HillBalliet/real-time-lightshow/Parts.txt

Wall Adapter:
    https://www.digikey.com/product-detail/en/cui-inc/SWI25-5-N-P5/102-4196-ND/7070092
    Price: $13.54
    Output Voltage: 5V
    Output Power: 20W
    Mate: https://www.digikey.com/product-detail/en/mpd-memory-protection-devices/EJ503A/EJ503A-ND/5431753

    https://www.digikey.com/product-detail/en/triad-magnetics/WSU050-1500/237-1417-ND/3094943
    Price: $7.75
    Output Voltage: 5V
    Output Power: 7.5W

MOSFETs:
    https://www.digikey.com/product-detail/en/diodes-incorporated/DMP2215L-7/DMP2215LDICT-ND/1774242
    Manufacturer: Diodes Incorporated
    Manufacturer PN: DMP2215L-7
    Type: P channel
    Price: $0.32 at 10
    Vds: 20V
    Rds On: 100mOhm
    Drive voltage: 2.5, 4.5V
    Continuous Current: 2.7A

    https://www.digikey.com/product-detail/en/rohm-semiconductor/RU1J002YNTCL/RU1J002YNTCLCT-ND/5042587
    Manufacturer: Rohm Semiconductor
    Manufacturer PN: RU1J002YNTCL
    Type: N channel
    Price: $0.23
    Vds: 50V
    Rds On: 2.2Ohm
    Drive voltage: 0.9, 4.5V
    Continuous Current: 200mA

Current limiting resistors (for n-channel mosfet)
    Manufacturer: TE Connectivity Passive Product
    Manufacturer PN: CRG0402J1K0
    Resistance: 1 kOhm
    Power Rating: 1/16 W
    Footprint: 0402

MuddPi Connector
    URL: https://www.digikey.com/product-detail/en/sullins-connector-solutions/PPPC201LFBN-RC/S7053-ND/810192

RasPi Connector
    URL: https://www.digikey.com/product-detail/en/sullins-connector-solutions/SFH11-PBPC-D20-ST-BK/S9200-ND/1990093

LED Connector
    Stock room 16 pin header

Board Vendor
    URL: http://docs.oshpark.com/services/
    Pricing: $5 per in^2 for 3 boards
    Shipping time: 12 days
    Trace Space: 6 mil
    Drill Size: 10 mil
    Annular Ring: 5 mil
