HillBalliet/real-time-lightshow/power_board.kicad_pcb

## KiCad design power_board.kicad_pcb (2017-10-31)

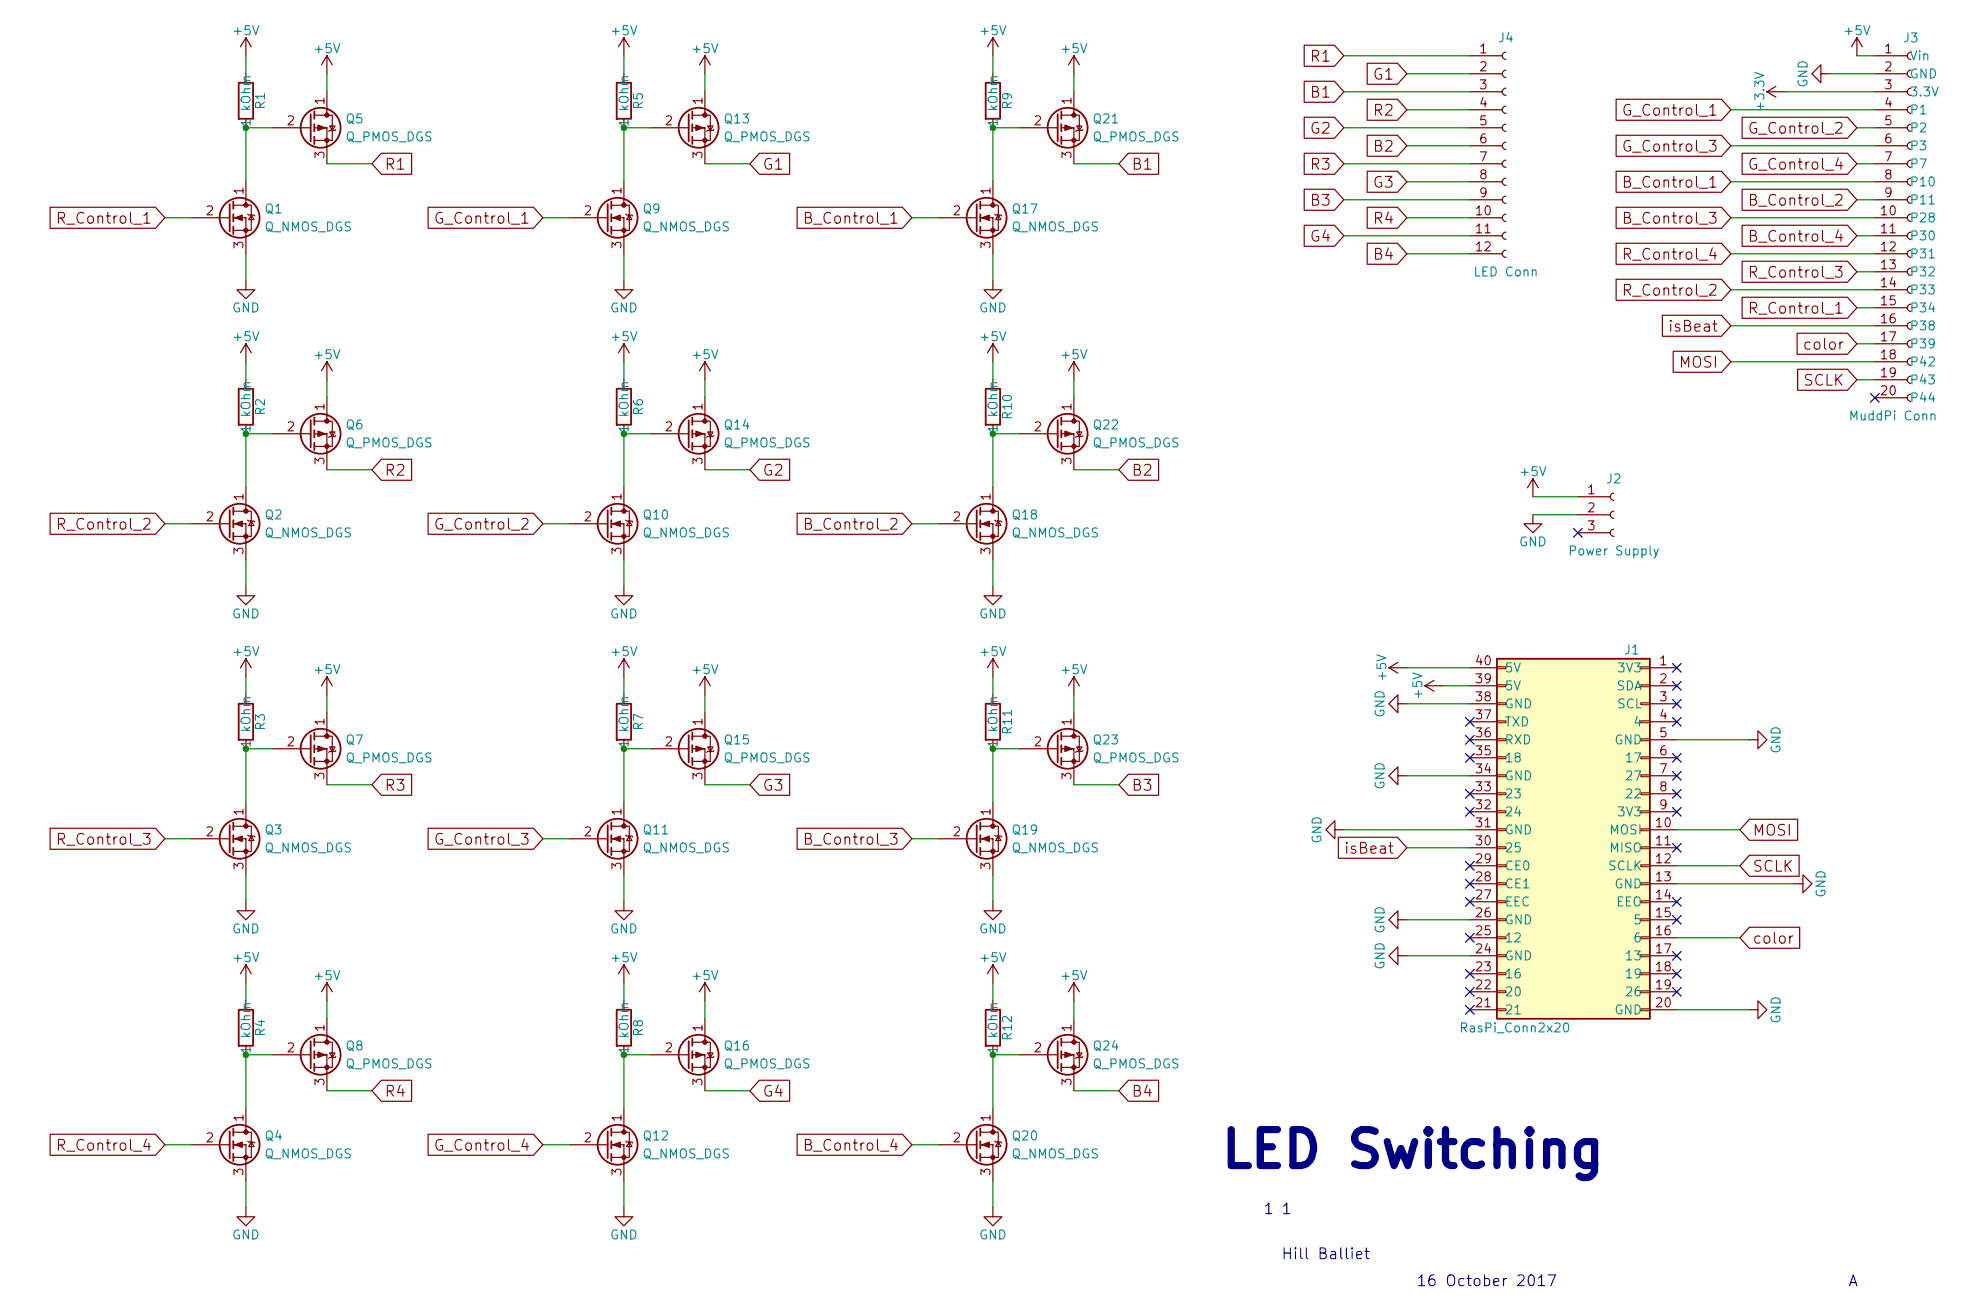
[picture p1: schematic power_board.sch]

Parts:
J1: RasPi_Conn2x20; Molex_2x20
J2: Power Supply; BARREL_JACK
J3: MuddPi Conn; Molex_1x20; Manufacturer PN PPPC201LFBN-RC
J4: LED Conn; Molex_KK-6410-12_12x2.54mm_Straight
Q1, Q2, Q3, Q4, Q9, Q10, Q11, Q12, Q17, Q18, Q19, Q20: Q_NMOS_DGS; SOT-323FL; Drive Voltage 0.9, 4.5V; Manufacturer PN RU1J002YNTCL
Q5, Q6, Q7, Q8, Q13, Q14, Q15, Q16, Q21, Q22, Q23, Q24: Q_PMOS_DGS; SOT-23; Drive Voltage 2.5, 4.5V; Manufacturer PN DMP2215L-7
R1, R2, R3, R4, R5, R6, R7, R8, R9, R10, R11, R12: 1 kOhm; R_0402; Manufacturer PN CRG0402J1K0

Connections:
+3V3: J3.3 (3.3V)
+5V: J1.39 (5V), J1.40 (5V), J2.1, J3.1 (Vin), Q5.1 (D), Q6.1 (D), Q7.1 (D), Q8.1 (D), Q13.1 (D), Q14.1 (D), Q15.1 (D), Q16.1 (D), Q21.1 (D), Q22.1 (D), Q23.1 (D), Q24.1 (D), R1.1, R2.1, R3.1, R4.1, R5.1, R6.1, R7.1, R8.1, R9.1, R10.1, R11.1, R12.1
B1: J4.3, Q21.3 (S)
B2: J4.6, Q22.3 (S)
B3: J4.9, Q23.3 (S)
B4: J4.12, Q24.3 (S)
B_Control_1: J3.8 (P10), Q17.2 (G)
B_Control_2: J3.9 (P11), Q18.2 (G)
B_Control_3: J3.10 (P28), Q19.2 (G)
B_Control_4: J3.11 (P30), Q20.2 (G)
G1: J4.2, Q13.3 (S)
G2: J4.5, Q14.3 (S)
G3: J4.8, Q15.3 (S)
G4: J4.11, Q16.3 (S)
GND: J1.5 (GND), J1.13 (GND), J1.20 (GND), J1.24 (GND), J1.26 (GND), J1.31 (GND), J1.34 (GND), J1.38 (GND), J2.2, J3.2 (GND), Q1.3 (S), Q2.3 (S), Q3.3 (S), Q4.3 (S), Q9.3 (S), Q10.3 (S), Q11.3 (S), Q12.3 (S), Q17.3 (S), Q18.3 (S), Q19.3 (S), Q20.3 (S)
G_Control_1: J3.4 (P1), Q9.2 (G)
G_Control_2: J3.5 (P2), Q10.2 (G)
G_Control_3: J3.6 (P3), Q11.2 (G)
G_Control_4: J3.7, Q12.2 (G)
MOSI: J1.10 (MOSI), J3.18 (P42)
unnamed: Q1.1 (D), Q5.2 (G), R1.2
unnamed: Q2.1 (D), Q6.2 (G), R2.2
unnamed: Q3.1 (D), Q7.2 (G), R3.2
unnamed: Q4.1 (D), Q8.2 (G), R4.2
unnamed: Q10.1 (D), Q14.2 (G), R6.2
unnamed: Q11.1 (D), Q15.2 (G), R7.2
unnamed: Q12.1 (D), Q16.2 (G), R8.2
unnamed: Q9.1 (D), Q13.2 (G), R5.2
unnamed: Q17.1 (D), Q21.2 (G), R9.2
unnamed: Q18.1 (D), Q22.2 (G), R10.2
unnamed: Q19.1 (D), Q23.2 (G), R11.2
unnamed: Q20.1 (D), Q24.2 (G), R12.2
R1: J4.1, Q5.3 (S)
R2: J4.4, Q6.3 (S)
R3: J4.7, Q7.3 (S)
R4: J4.10, Q8.3 (S)
R_Control_1: J3.15 (P34), Q1.2 (G)
R_Control_2: J3.14 (P33), Q2.2 (G)
R_Control_3: J3.13 (P32), Q3.2 (G)
R_Control_4: J3.12 (P31), Q4.2 (G)
SCLK: J1.12 (SCLK), J3.19 (P43)
color: J1.16 (6), J3.17 (P39)
isBeat: J1.30 (25), J3.16 (P38)

Notes on the sheet:
LED Switching
16 October 2017
Hill Balliet

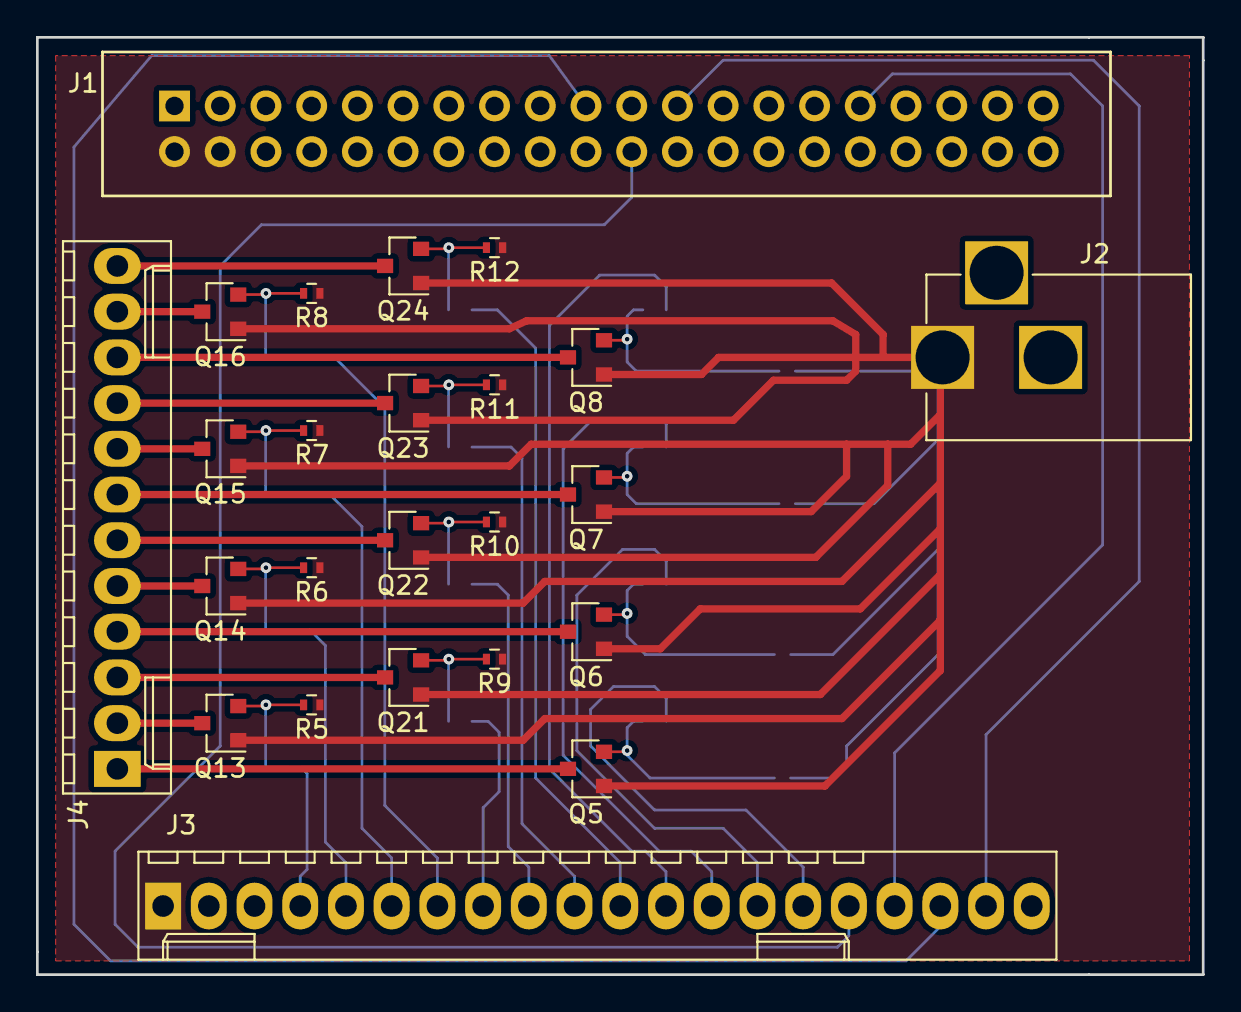
[picture p2: board power_board.kicad_pcb from above]

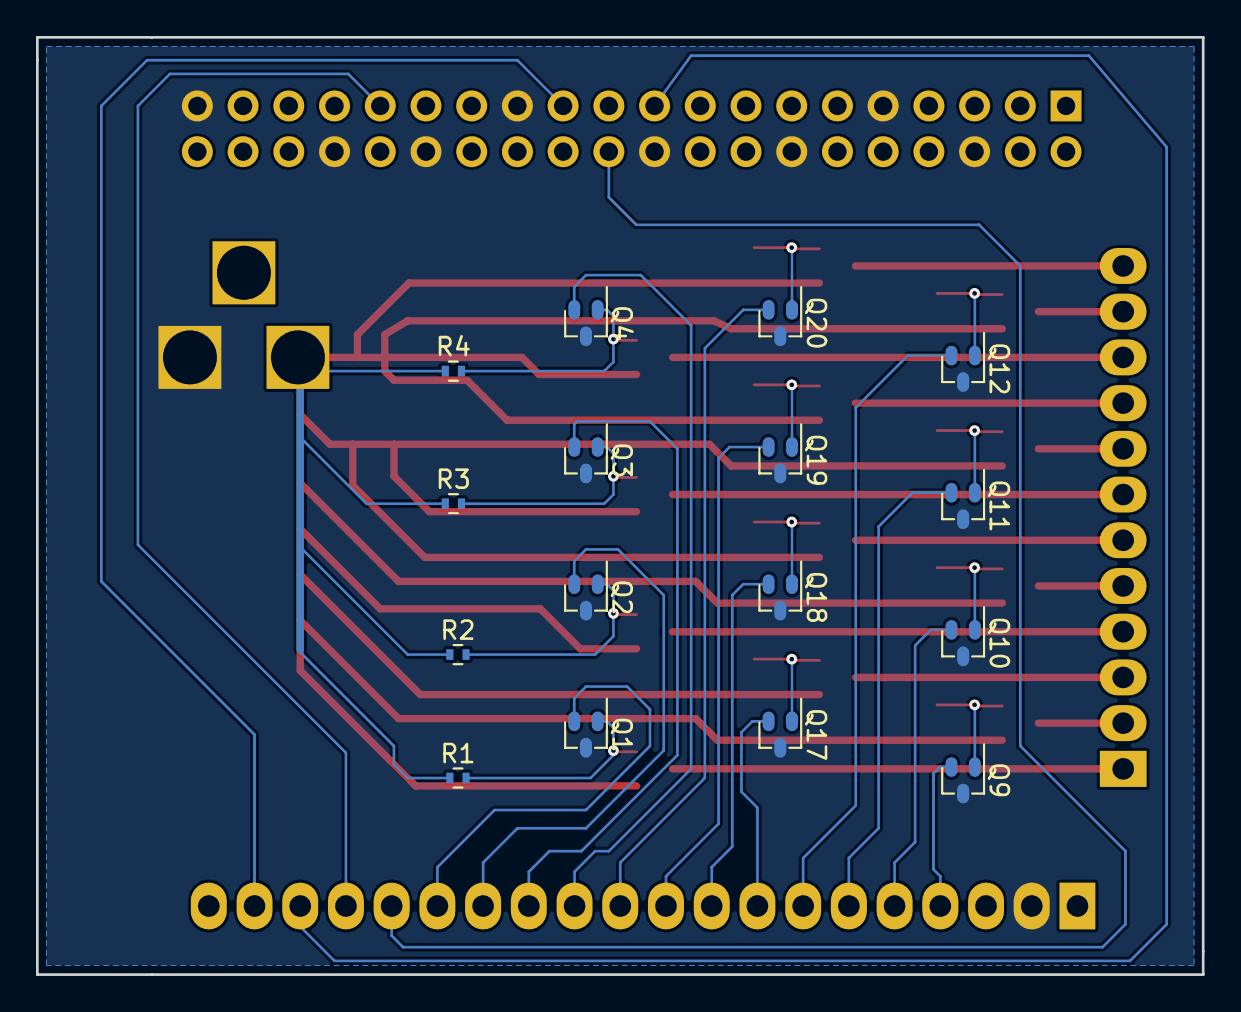
[picture p3: board power_board.kicad_pcb from below]

Board: 2 copper layers, 64.8 x 52.1 mm, 40 parts (16 on the bottom side), 42 nets.
