HillBalliet/real-time-lightshow/(commit log)

2017-09-28 Adding more Raspberry Pi code for beat finding and audio data processing from the MicroPs final project. Also adding web controller documents for picking the color of the LEDs.
2017-09-28 List of potential parts. Currently includes 2 wall adapter alternatives
2017-10-03 removed the non-current/non-hardware files
2017-10-03 Found MOSFETs and started the KiCAD project
    [power_board.kicad_pcb, power_board.sch]
2017-10-05 Added to the list of parts and started putting parameters on parts in the schematic
    [power_board.sch]
2017-10-17 Finished schematics first draft for switching board and found all parts for the board
    [power_board.sch]
2017-10-18 Added footprint to the power supply jack. Fixed a wrong part (raspi connector was 10x2 is now 20x2)
    [power_board.sch]
2017-10-18 Improved schematic symbols and finished making all footprints. (Need to be checked before finalization)
    [power_board.sch]
2017-10-19 Added info for best board manufacturer and fixed issues with connections on the schematic. Checked pinouts
    [power_board.sch]
2017-10-19 Added schematic for the LED output connector
    [power_board.sch]
2017-10-22 Finished initial layout and changed the pinout of the MuddPi connector so that the board would be easier to route
    [power_board.sch]
2017-10-31 Fixed some issues with the layout and made it conform to the OSH Park manufacturing specifications. Ordered the board!!!
    [power_board-B.Cu.GBL, power_board-B.Mask.GBS, power_board-B.Paste.GBP, power_board-B.SilkS.GBO, power_board-Edge.Cuts.GKO.gbr, power_board-F.Cu.GTL, power_board-F.Mask.GTS, power_board-F.Paste.GTP]
